Sonoscopia/KidModular/README.md

# KidModular
(Semi)Modular synthesisers for InSono project (2017 @CCB-Lisbon)

## List of modules
- Oscillator
- Sequencer
- (Active?) Multiples
- DistCV
- PressCV
- Mixer 2ch 

## Acknowledgment
- Henning Karlsen (Arduino UTFT Library)
- Tim Barrass (Mozzi Library)

## Version
Revision B

## List of Changes 
- Oscillator now has 2 Arduinos: a MEGA2560 to handle the screen and UI hardware and a Pro Mini (5V) to handle sound synthesis
