Sonoscopia/KidModular/examples/Arduino-to-Arduino via I2C while using Mozzi/README.md

# Arduino-to-Arduino via I2C while using Mozzi

This example explores non-blocking i2c to communicate between two arduinos while maintaining a sound synthesis engine running using Mozzi. 

## Instructions
