Sonoscopia/KidModular/Oscillator_revB/board and schematics/Oscillator_RevB_BOTTOM.pdf

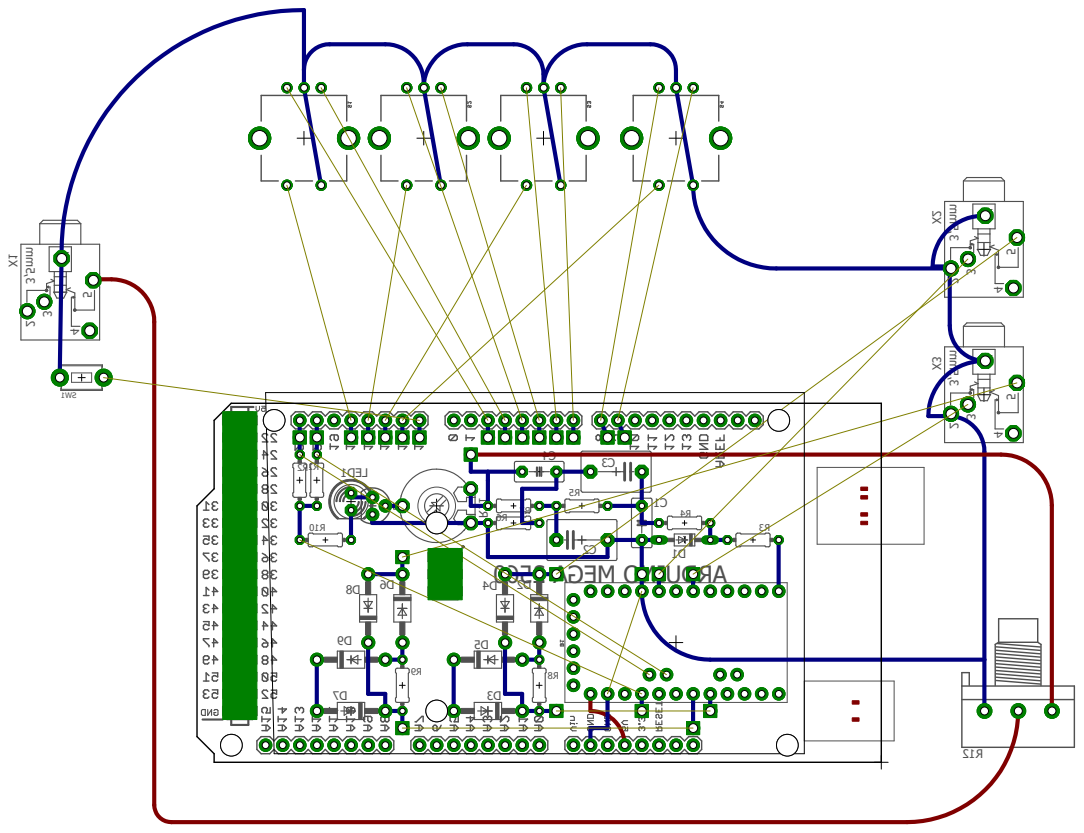
[picture p1: page 1]

1C 2C 3C 4C 1D 2D 3D 4D 5D 6D 7D8D 9D1DEL 1R01R R11 21R 2R 3R 4R 5R 6R 7R 8R 9R 1 WS X1 X2 X3 1 2 3 4 5 1 2 3 4 5 1 2 3 4 5 0652 AGE M ONI UDRA 3,5mm 3,5mm 3,5mm
