Sonoscopia/KidModular/Oscillator_revB/board and schematics/Oscillator_RevB.brd

## EAGLE design Oscillator_revB/board and schematics/Oscillator_RevB.brd (2018-04-15)

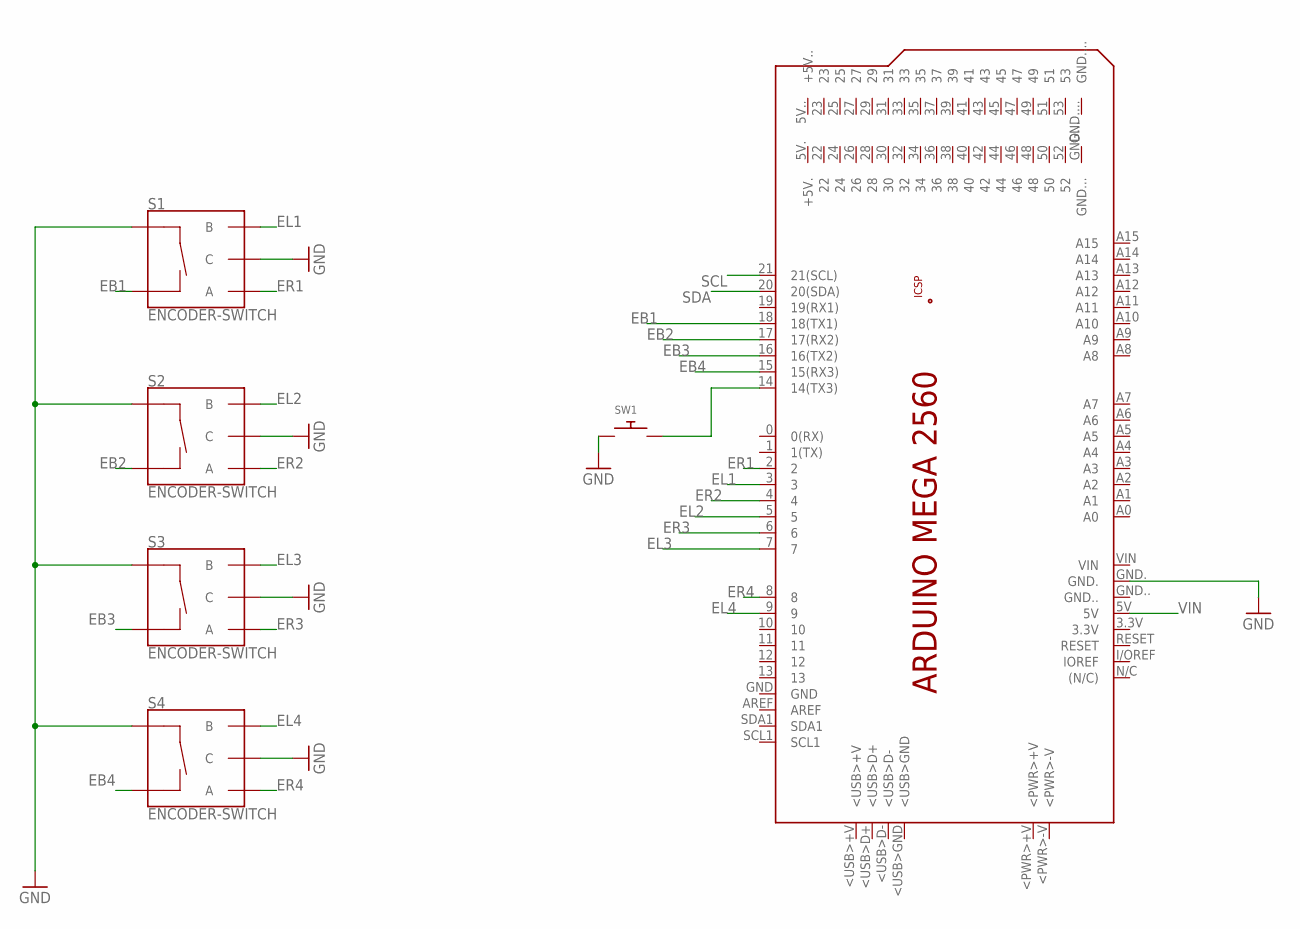
[picture p2: schematic Oscillator_RevB.sch, sheet 1]

Parts:
PCB1: ARDUINO_MEGA2560
S1, S2, S3, S4: ENCODER-SWITCH; ROTARY_ENC_PLAIN
SW1: SWITCH_PUSHBUTTONEVQ-PE; TACT_PANA-EVQ

Connections:
EB1: PCB1.18 (18(TX1)), S1.SW-
EB2: PCB1.17 (17(RX2)), S2.SW-
EB3: PCB1.16 (16(TX2)), S3.SW-
EB4: PCB1.15 (15(RX3)), S4.SW-
EL1: PCB1.3, S1.B
EL2: PCB1.5, S2.B
EL3: PCB1.7, S3.B
EL4: PCB1.9, S4.B
ER1: PCB1.2, S1.A
ER2: PCB1.4, S2.A
ER3: PCB1.6, S3.A
ER4: PCB1.8, S4.A
GND: PCB1.GND., S1.C, S1.SW+, S2.C, S2.SW+, S3.C, S3.SW+, S4.C, S4.SW+, SW1.P$1; also elsewhere on the board
unnamed: PCB1.14 (14(TX3)), SW1.P$2
SCL: PCB1.21 (21(SCL)); also elsewhere on the board
SDA: PCB1.20 (20(SDA)); also elsewhere on the board
VIN: PCB1.5V; also elsewhere on the board

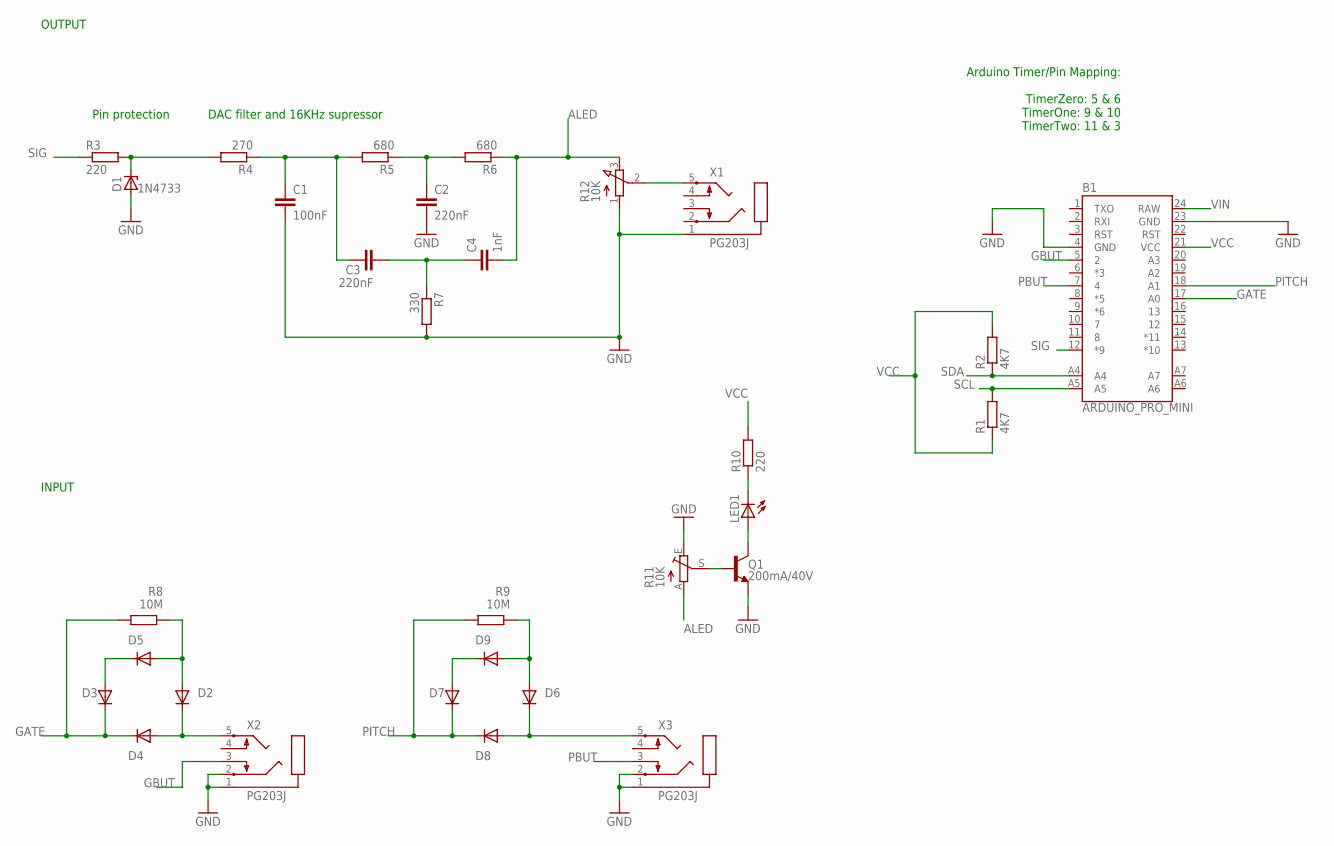
[picture p3: schematic Oscillator_RevB.sch, sheet 2]

Parts:
B1: ARDUINO_PRO_MINI
C1: 100nF; C5B3
C2, C3: 220nF; C7.5B6
C4: 1nF; C5B3
D1: 1N4733; DO34Z7
D2, D3, D4, D5, D6, D7, D8, D9: 1N4004; DO41-10
LED1: LED5MM
Q1: 200mA/40V; TO-92
R1, R2: 4K7; 0204/7
R3, R10: 220; 0204/7
R4: 270; 0204/7
R5, R6: 680; 0204/7
R7: 330; 0204/7
R8, R9: 10M; 0204/7
R11: 10K; LI10
R12: 10K; 3RP/1610N
X1, X2, X3: PG203J

Connections:
ALED: C4.2, R6.1, R11.A, R12.3 (E)
GATE: B1.17 (A0), D3.C, D4.C, R8.1
GBUT: B1.5 (2), X2.3
GND: B1.4 (GND), B1.23 (GND), C1.2, C2.2, D1.A, Q1.1 (E), R7.2, R11.E, R12.1 (A), X1.1, X2.1, X2.2, X3.1, X3.2; also elsewhere on the board
unnamed: LED1.A, Q1.3 (C)
unnamed: LED1.K (C), R10.1
unnamed: D1.C, R3.2, R4.2
unnamed: C1.1, C3.1, R4.1, R5.2
unnamed: C2.1, R5.1, R6.2
unnamed: C3.2, C4.1, R7.1
unnamed: D2.C, D4.A, X2.5
unnamed: D6.A, D9.A, R9.2
unnamed: D2.A, D5.A, R8.2
unnamed: D3.A, D5.C
unnamed: D7.A, D9.C
unnamed: Q1.2 (B), R11.S
unnamed: R12.2 (S), X1.5
PBUT: B1.7 (4), X3.3
PITCH: B1.18 (A1), D7.C, D8.C, R9.1
PIT_IN: D6.C, D8.A, X3.5
SCL: B1.A5, R1.2; also elsewhere on the board
SDA: B1.A4, R2.1; also elsewhere on the board
SIG: B1.12 (*9), R3.1
VCC: B1.21 (VCC), R1.1, R2.2, R10.2
VIN: B1.24 (RAW); also elsewhere on the board

Notes on the sheet:
Arduino Timer/Pin Mapping: TimerZero: 5 & 6 TimerOne: 9 & 10 TimerTwo: 11 & 3
Pin protection
DAC filter and 16KHz supressor
OUTPUT
INPUT

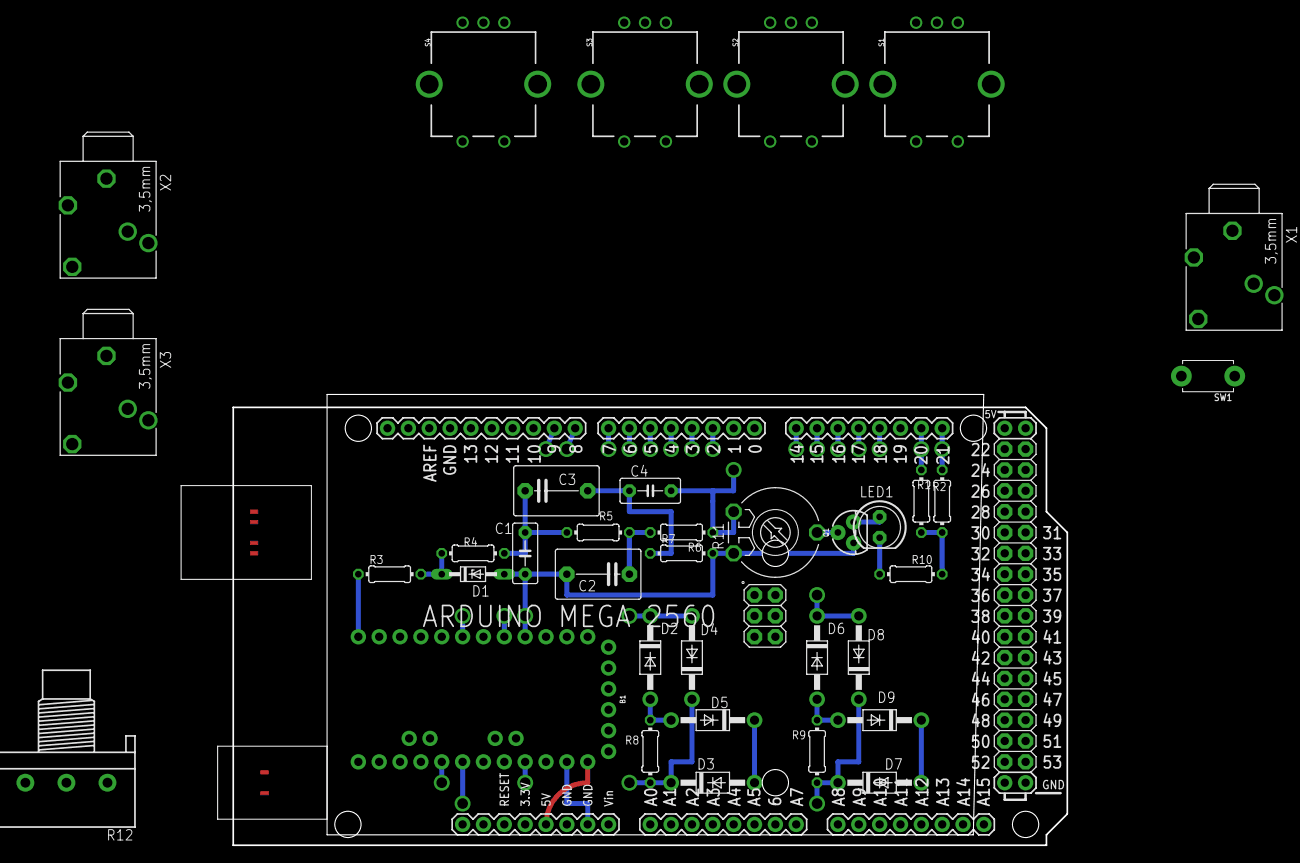
[picture p4: board Oscillator_RevB.brd from above]

Board: 4 copper layers, 101.6 x 54.9 mm, 37 parts (0 on the bottom side), 38 nets.
