Sonoscopia/KidModular/hardware testers/Oscillator/CheckIncomingI2Cmessages/CheckIncomingI2Cmessages.ino

#define bit_get(p,m) ((p) & (m))
#define bit_set(p,m) ((p) |= (m))
#define bit_clear(p,m) ((p) &= ~(m))
#define BIT(x)(0x01 << (x))
#define reconstruct(l, u) (l | (u << 8)) // make int from two bytes
/*  Example playing a sinewave at a frequency given by another Arduino (see SlaveController_sender.ino)
    using Mozzi sonification library.
  
    Demonstrates the use of Oscil to play a wavetable and non-blocking I2C communication from another Arduino
    
    Circuit: Audio output on digital pin 9 on a Uno or similar, or
    [connect SDA, SCL and GND between Arduinos]
    DAC/A14 on Teensy 3.1, or 
    check the README or http://sensorium.github.com/Mozzi/
  
    Mozzi help/discussion/announcements:
    https://groups.google.com/forum/#!forum/mozzi-users
  
    Tim Barrass 2012, CC by-nc-sa.
    (slightly modified by p1nh0)
*/
#include <twi_nonblock.h> 
#include <MozziGuts.h>
#include <Oscil.h> // oscillator template
#include <tables/sin2048_int8.h> // sine table for oscillator

// use: Oscil <table_size, update_rate> oscilName (wavetable), look in .h file of table #included above
Oscil <SIN2048_NUM_CELLS, AUDIO_RATE> aSin(SIN2048_DATA);

// use #define for CONTROL_RATE, not a constant
#define CONTROL_RATE 64 // powers of 2 please
#define I2C_ADDRESS 8 
byte val[3] = {0, 0, 0}; 

void setup(){
  //startMozzi(CONTROL_RATE); // set a control rate of 64 (powers of 2 please)
  //aSin.setFreq(440); // set the frequency
  Serial.begin(9600);
  initialize_twi_nonblock();
}


/*void updateControl(){
  // put changing controls in here
  byte read = twi_readFromBlocking(I2C_ADDRESS, val, 1);
  aSin.setFreq(val[0]<<2); // set the frequency
}


int updateAudio(){
  return aSin.next(); // return an int signal centred around 0
}*/


void loop(){
  byte reading = twi_readFromBlocking(I2C_ADDRESS, val, 3);
  //byte paramAddr = val[0] & 0xFF;
    //Serial.println( bit_get(val[0], BIT(7)) );
    //Serial.println(val[0]);
    if( !bit_get(val[0], BIT(7)) ){ // if bit num 7 == 0 then there is data
     Serial.print("menu: ");
     Serial.print(val[0] & 0x0F);
     Serial.print("   param: ");
     Serial.println(val[0] >> 4);
     Serial.print("value: ");
     Serial.println(reconstruct(val[1], val[2]));
    }

//  audioHook(); // required here
}
