Sonoscopia/KidModular/Oscillator_revB/OscillatorController/OscillatorController/OscillatorController/Window.cpp

#include "Window.h"

/**
 * Window implementation
 * 
 * This class draws the window (middle section of the screen) representing synthesis parameters
 */

Window::Window() {

}

void Window::init(UTFT* u, uint8_t* sF, uint8_t* bF, params_t* p) {

}

void Window::drawOscillator() {

}

void Window::drawFilter() {

}

void Window::drawEnvelope() {

}

void Window::drawFx() {

}

void Window::drawSettings() {

}
