Sonoscopia/KidModular/(commit log)

2017-01-27 Added encoder example
2017-01-29 Fully functional prototype
2017-01-30 first functional prototype
2017-01-30 added example of how to use osc freq controlled by encoder without interrupts
2017-01-30 added control class w/ no errors but not working properly
    [Screen.cpp, Screen.h]
2017-01-30 removed control class. Freq control is working w/ encoder
2017-02-06 v.0.1.0 first version mounted on the box
2017-02-07 added Pitch output
2017-02-07 fix pitch output to conform to 1V/oct fro 0 to 5V
    [Sequencer.ino]
2017-02-08 fixed bug when changing numSteps
    [Sequencer.ino]
2017-02-08 crude implementation of Gate and Pitch CV
2017-06-15 DistCV v0.1
    sonar distance to CV
2018-03-16 Added Examples
    - Arduino to Arduino via I2C (basic)
    - Arduino to Arduino via I2C (while using Mozzi)
    - Menu Button edge detection
    - Passing structures to functions
    - Passing structures to class methods
2018-03-16 Moved Oscillator to Oscillator_revA
    this will only be kept while revB is not ready
    [Screen.cpp, Screen.h]
2018-03-16 Oscillator revB first upload
    - draw and select top menu
    [Parameters.h, Screen.cpp, Screen.h]
2018-03-16 Oscillator change
    placed all synthesis variables in a struct inside Parameters.h
    then referencing the struct object from other classes
    [Parameters.h, Screen.cpp, Screen.h]
2018-03-16 Oscillator: added bottom menu
    [Parameters.h, Screen.cpp, Screen.h]
2018-03-16 Added encoder example with tidy class
2018-03-21 added EncoderHandler class
    this handles encoder behaviour
2018-03-22 Managed to read encoder data from Control object
2018-03-22 Managed to read encoder from EncoderHandler
2018-03-23 Managed to set parameters.data from EncoderHandler
2018-03-23 implemented clip() function to limit parameter setting in EncoderHandler
2018-03-23 added menu button reading
2018-03-23 Implemente parameter control (still with some bugs)
    [Control.cpp, Control.h, GLOBALS.h, Menu.cpp, Parameters.h, Screen.cpp]
2018-03-24 Improved EncoderHandler
2018-03-24 replaced Encoder library by Rotary and added TimerOne as well
    encoders weren't properly read because UTFT was hogging the cpu
    so encoders are now read in a ISR in Timer1
    see examples/testTimerOneEncodersUTFT
2018-03-24 successfull implementation of Rotary and TimerOne
    TO DO (next):
    - send data via I2C
2018-03-25 Implemented 1st I2C prototype
2018-03-25 fixed issues caused by refactoring parameters variable types
    [Control.cpp, EncoderHandler.cpp, EncoderHandler.h, GLOBALS.h, Menu.cpp, Parameters.h, Sketch.cpp]
2018-03-25 added hardware tester for I2C messages
2018-03-25 finished implementing I2C on sender (controller)
2018-03-29 updated DistCV to version 0.2
    several fixes and improvementes
    [Sketch.cpp]
2018-03-29 changed pins due to timers
2018-03-31 Updated DistCV code
    included an average sensor value
2018-04-02 fixed wrong wire.send message
    [Sketch.cpp]
2018-04-02 1st working example of I2C using twi_nonblock
2018-04-02 Fixed I2C to only send data on parameter changes
    [Sketch.cpp]
2018-04-15 schematic and BOM upload
    [Oscillator_RevB.brd, Oscillator_RevB.sch]
